wipcomputer/airplay-manual-vol/docs/design/01-front-view.png

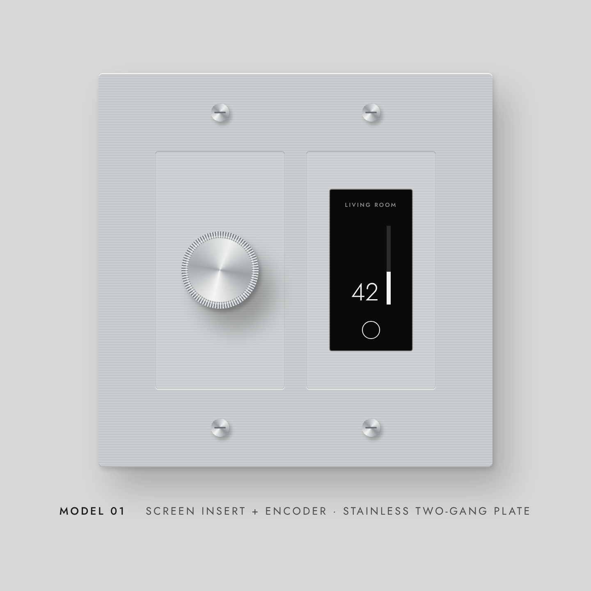
docs/design/01-front-view.png
