wipcomputer/airplay-manual-vol/docs/design/02-screen-states.png

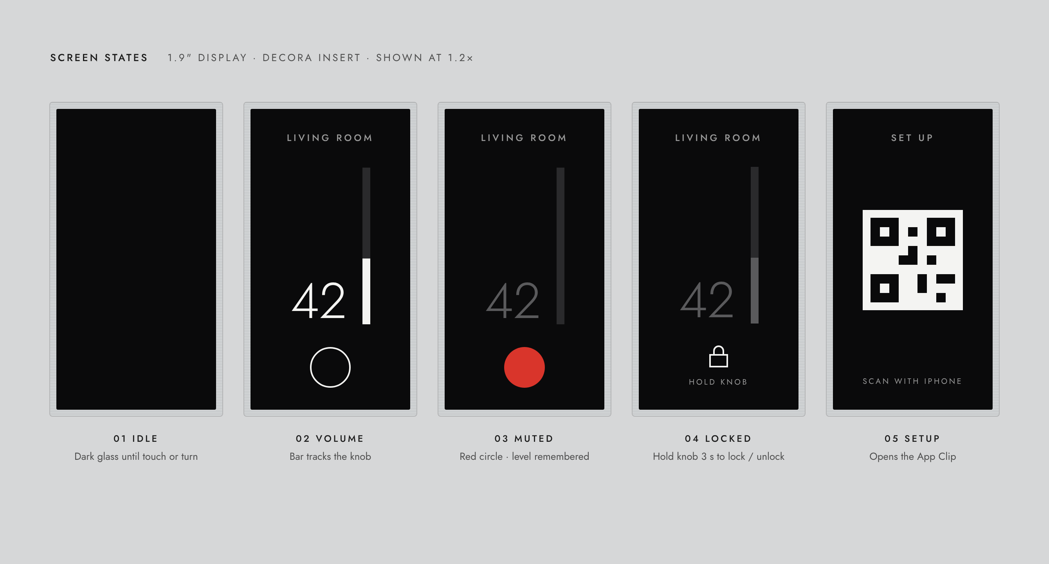
docs/design/02-screen-states.png
