wipcomputer/airplay-manual-vol/hardware/models/2k-knob2-bracket.stl

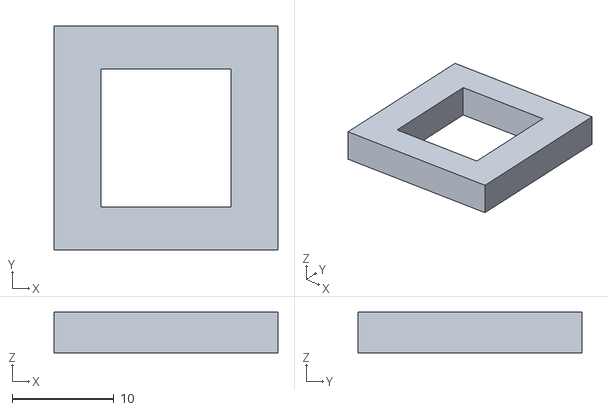
[picture p10: CAD file, 2026-10-14]
hardware/models/2k-knob2-bracket.stl
22.0 x 22.0 x 4.00
