wipcomputer/airplay-manual-vol/hardware/models/print/screen-acrylic.step

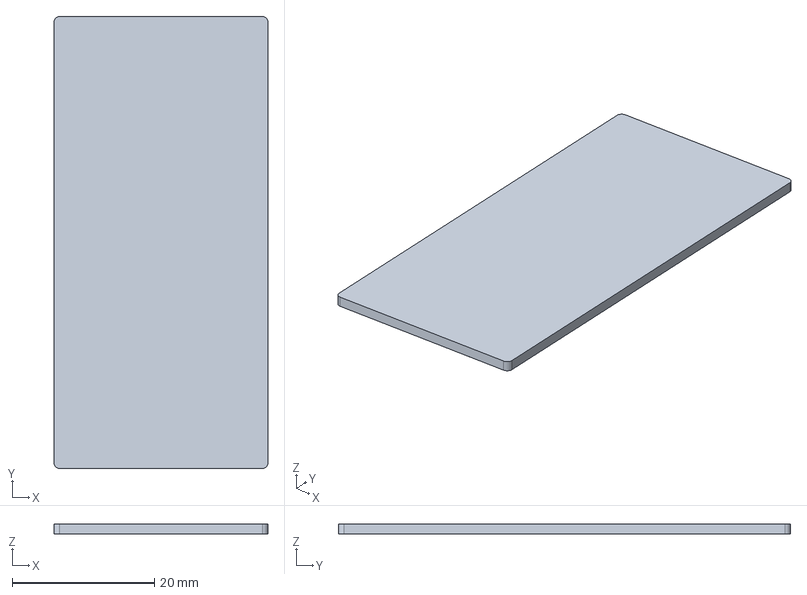
[picture p11: CAD file, 2026-10-14]
hardware/models/print/screen-acrylic.step
30.1 x 63.6 x 1.45 mm
