wipcomputer/airplay-manual-vol/hardware/models/3k-knob2-knob.stl

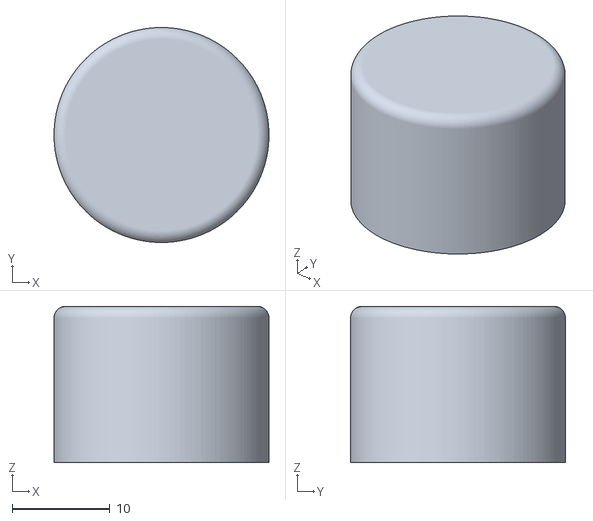
[picture p12: CAD file, 2026-10-14]
hardware/models/3k-knob2-knob.stl
22.0 x 22.0 x 16.0
