wipcomputer/airplay-manual-vol/hardware/models/print/knob-strap.step

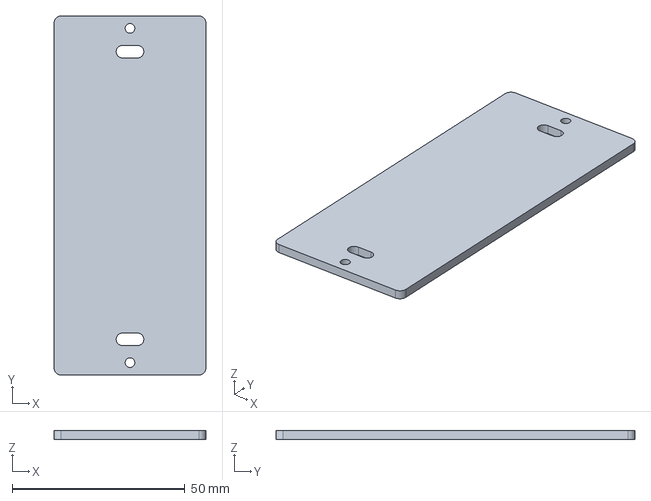
[picture p13: CAD file, 2026-10-14]
hardware/models/print/knob-strap.step
44.0 x 104.0 x 2.50 mm
