wipcomputer/airplay-manual-vol/hardware/models/1k-box.stl

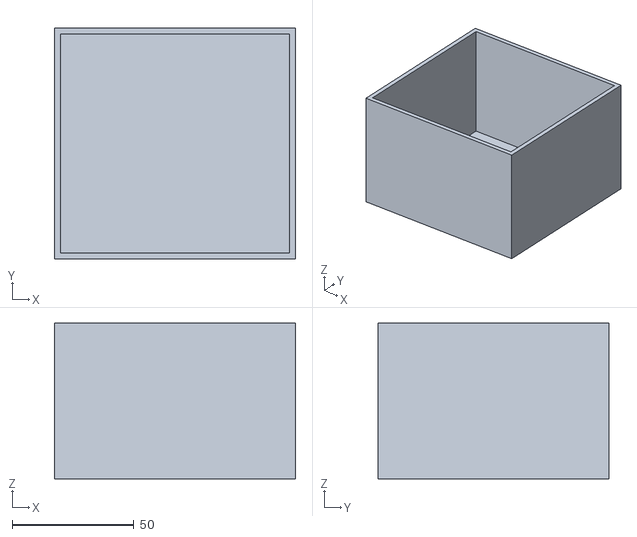
[picture p14: CAD file, 2026-10-14]
hardware/models/1k-box.stl
99.0 x 95.0 x 64.0
