wipcomputer/airplay-manual-vol/hardware/models/print/knob-face.step

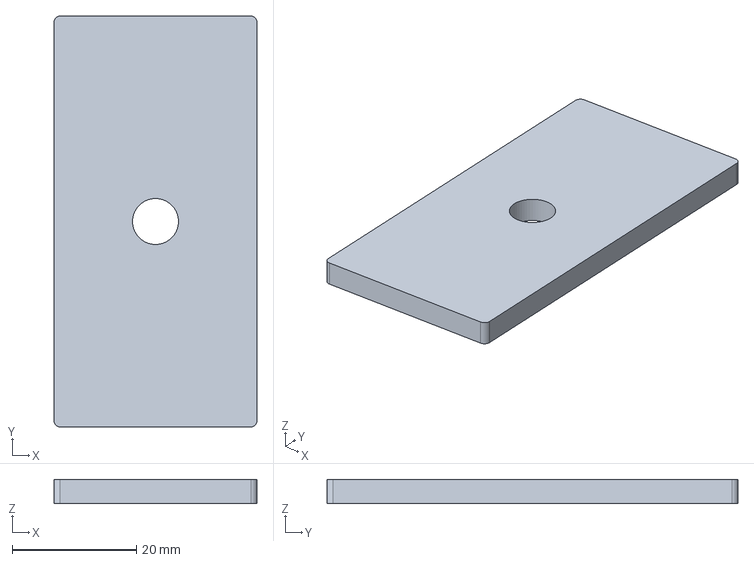
[picture p15: CAD file, 2026-10-14]
hardware/models/print/knob-face.step
32.7 x 66.2 x 3.90 mm
