wipcomputer/airplay-manual-vol/hardware/models/2k-box.stl

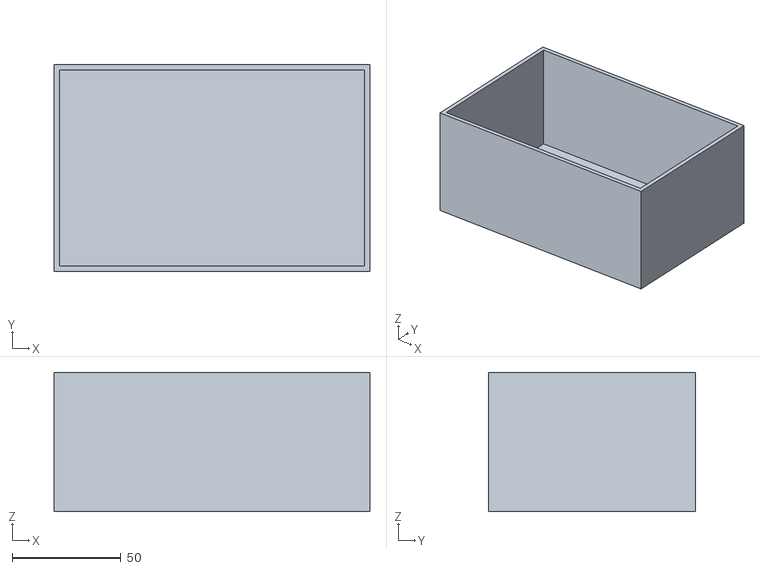
[picture p16: CAD file, 2026-10-14]
hardware/models/2k-box.stl
145.0 x 95.0 x 64.0
