wipcomputer/airplay-manual-vol/hardware/models/1k-knob1-encoder.stl

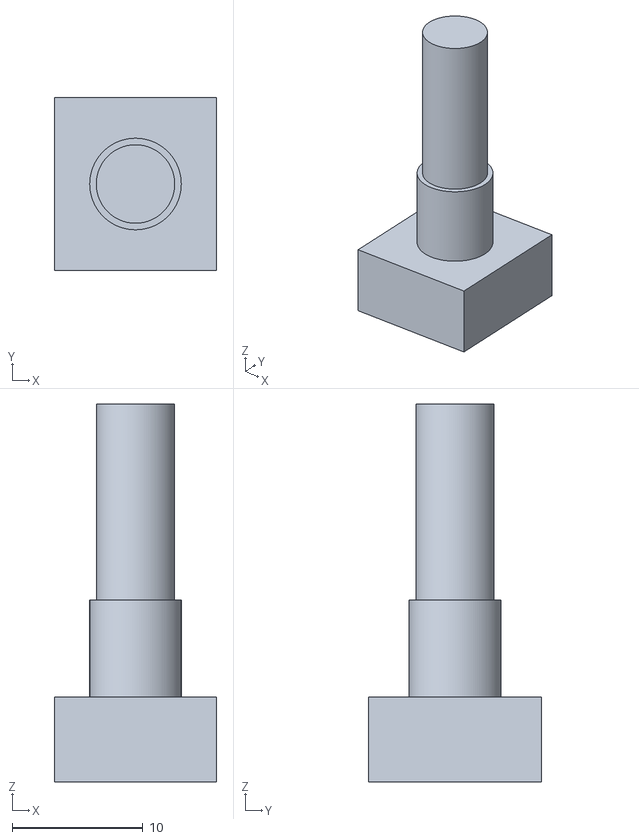
[picture p17: CAD file, 2026-10-14]
hardware/models/1k-knob1-encoder.stl
12.4 x 13.2 x 28.9
