wipcomputer/airplay-manual-vol/hardware/models/print/screen-face.step

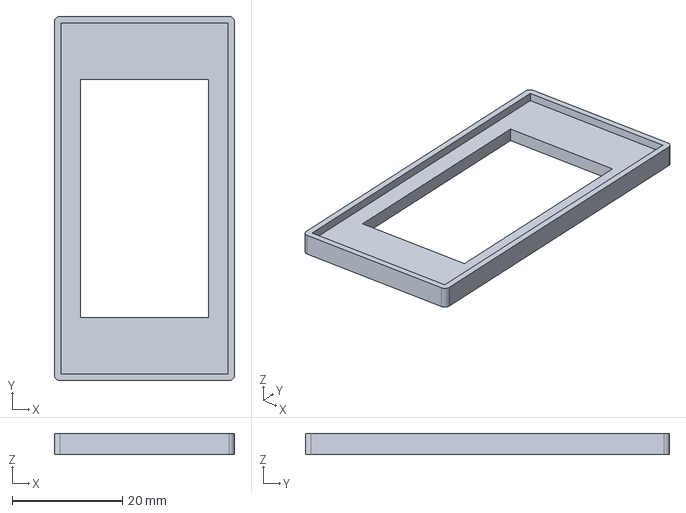
[picture p18: CAD file, 2026-10-14]
hardware/models/print/screen-face.step
32.7 x 66.2 x 3.90 mm
