wipcomputer/airplay-manual-vol/hardware/models/print/screen-housing.step

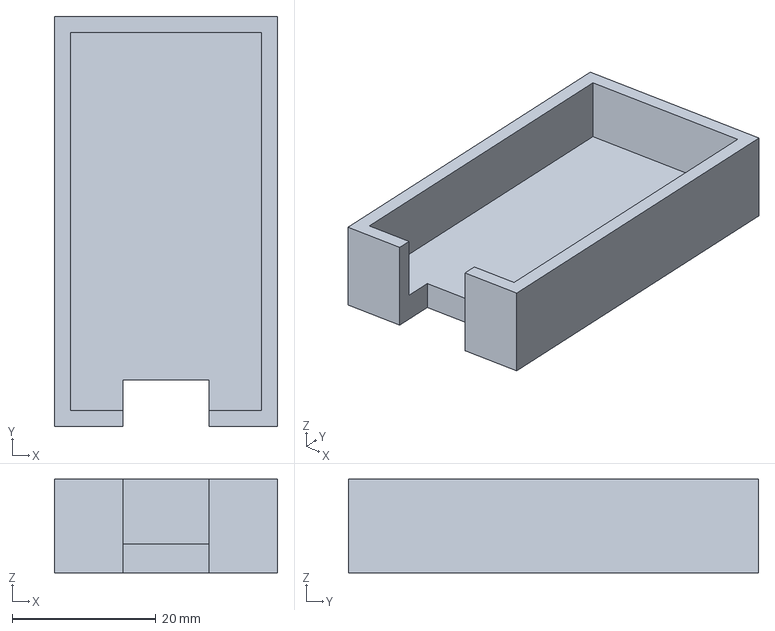
[picture p19: CAD file, 2026-10-14]
hardware/models/print/screen-housing.step
31.0 x 57.0 x 13.0 mm
