wipcomputer/airplay-manual-vol/hardware/models/2k-plate.stl

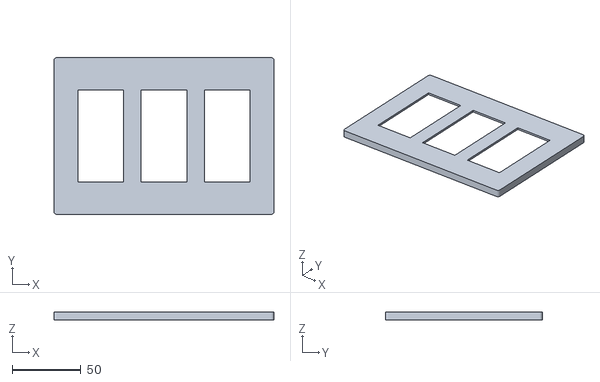
[picture p20: CAD file, 2026-10-14]
hardware/models/2k-plate.stl
160.3 x 114.3 x 6.00
