wipcomputer/airplay-manual-vol/hardware/models/3k-plate.stl

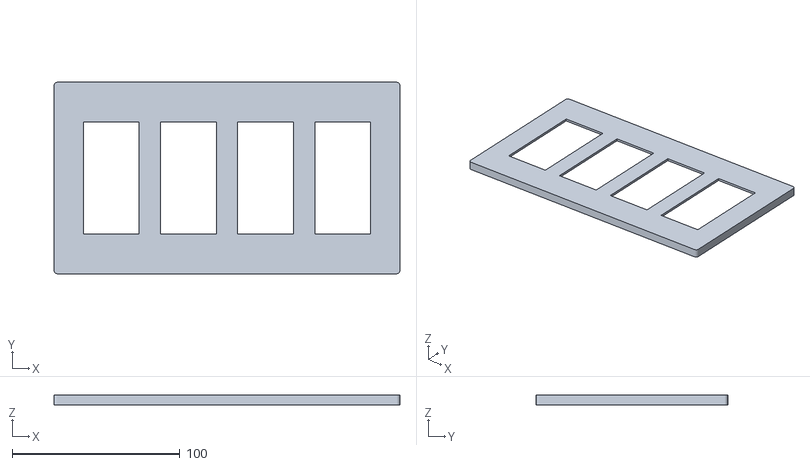
[picture p21: CAD file, 2026-10-14]
hardware/models/3k-plate.stl
206.4 x 114.3 x 6.00
