wipcomputer/airplay-manual-vol/hardware/models/2k-screen-board.stl

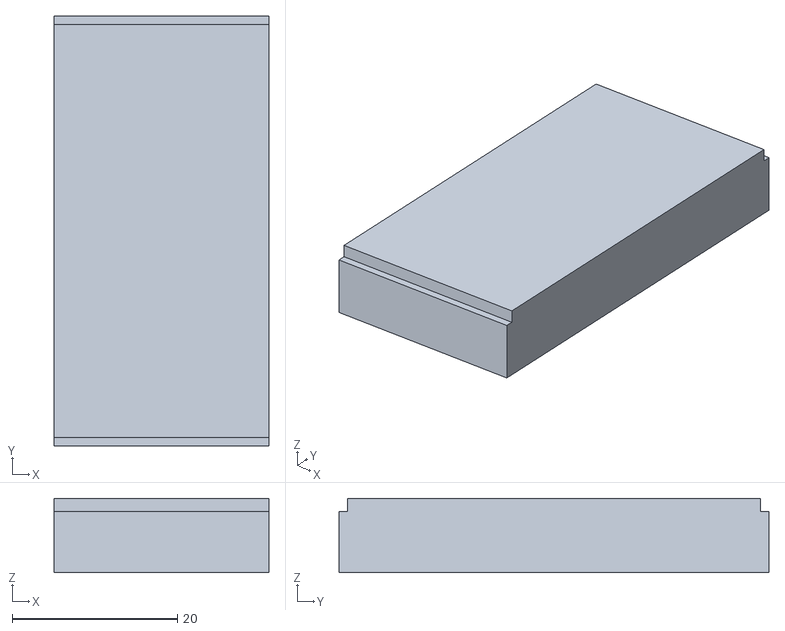
[picture p22: CAD file, 2026-10-14]
hardware/models/2k-screen-board.stl
26.0 x 52.0 x 9.00
