wipcomputer/airplay-manual-vol/hardware/models/3k-box.stl

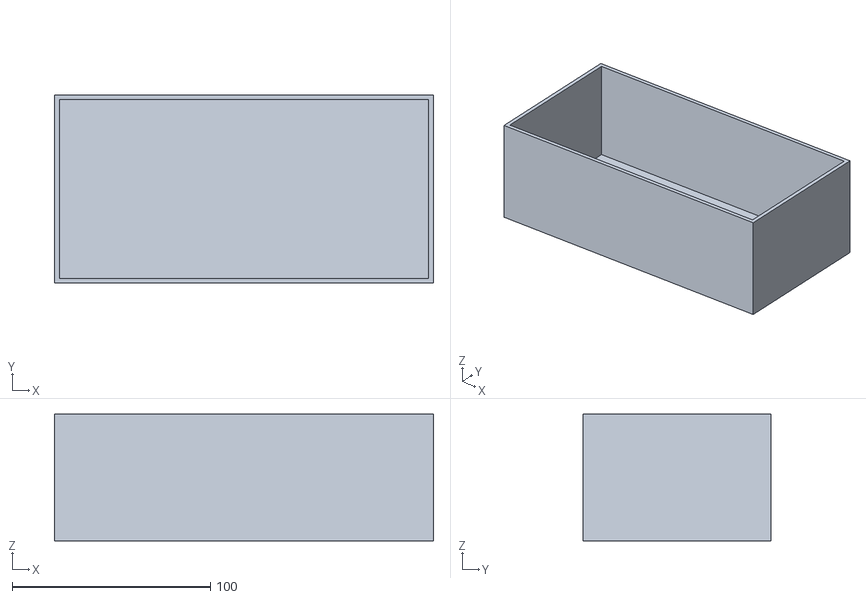
[picture p23: CAD file, 2026-10-14]
hardware/models/3k-box.stl
191.1 x 95.0 x 64.0
