wipcomputer/airplay-manual-vol/hardware/models/1k-plate.stl

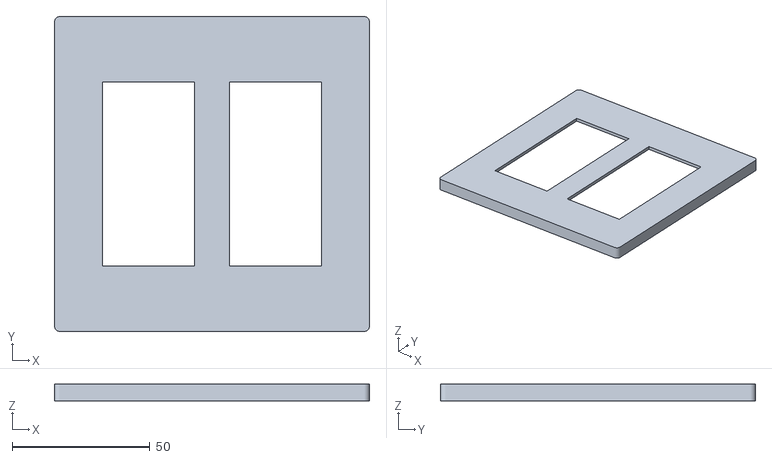
[picture p24: CAD file, 2026-10-14]
hardware/models/1k-plate.stl
114.3 x 114.3 x 6.00
