wipcomputer/airplay-manual-vol/(list of files, cad)

Other CAD files:
hardware/models/print/screen-strap.step
hardware/models/2k-screen-strap.stl
hardware/models/print/knob-bracket.step
hardware/models/1k-screen-face.stl
hardware/models/2k-knob1-face.stl
hardware/models/3k-knob3-face.stl
hardware/models/2k-knob2-knob.stl
hardware/models/3k-screen-strap.stl
hardware/models/2k-knob1-knob.stl
hardware/models/2k-knob1-strap.stl
hardware/models/2k-knob1-bracket.stl
hardware/models/2k-knob2-strap.stl
hardware/models/1k-knob1-strap.stl
hardware/models/3k-knob1-strap.stl
hardware/models/3k-screen-face.stl
hardware/models/3k-knob1-knob.stl
hardware/models/3k-knob2-face.stl
hardware/models/1k-screen-housing.stl
hardware/models/3k-screen-housing.stl
hardware/models/3k-knob1-bracket.stl
hardware/models/3k-knob3-strap.stl
hardware/models/2k-screen-acrylic.stl
hardware/models/1k-screen-acrylic.stl
hardware/models/2k-screen-housing.stl
hardware/models/1k-screen-strap.stl
hardware/models/1k-screen-board.stl
hardware/models/3k-knob3-encoder.stl
hardware/models/2k-screen-face.stl
hardware/models/2k-knob2-face.stl
hardware/models/3k-knob3-bracket.stl
hardware/models/2k-knob2-encoder.stl
hardware/models/3k-knob2-bracket.stl
hardware/models/1k-knob1-bracket.stl
hardware/models/3k-screen-board.stl
hardware/models/3k-knob2-strap.stl
hardware/models/2k-knob1-encoder.stl
hardware/models/3k-knob1-encoder.stl
hardware/models/3k-knob3-knob.stl
hardware/models/3k-knob1-face.stl
hardware/models/3k-screen-acrylic.stl
hardware/models/1k-knob1-face.stl
hardware/models/print/knob-bracket.stl
hardware/models/print/knob-face.stl
hardware/models/print/knob-strap.stl
hardware/models/print/screen-acrylic.dxf
hardware/models/print/screen-acrylic.stl
hardware/models/print/screen-face.stl
hardware/models/print/screen-housing.stl
hardware/models/print/screen-strap.stl
