wipcomputer/airplay-manual-vol/docs/design/Model-01-Mockups.pdf

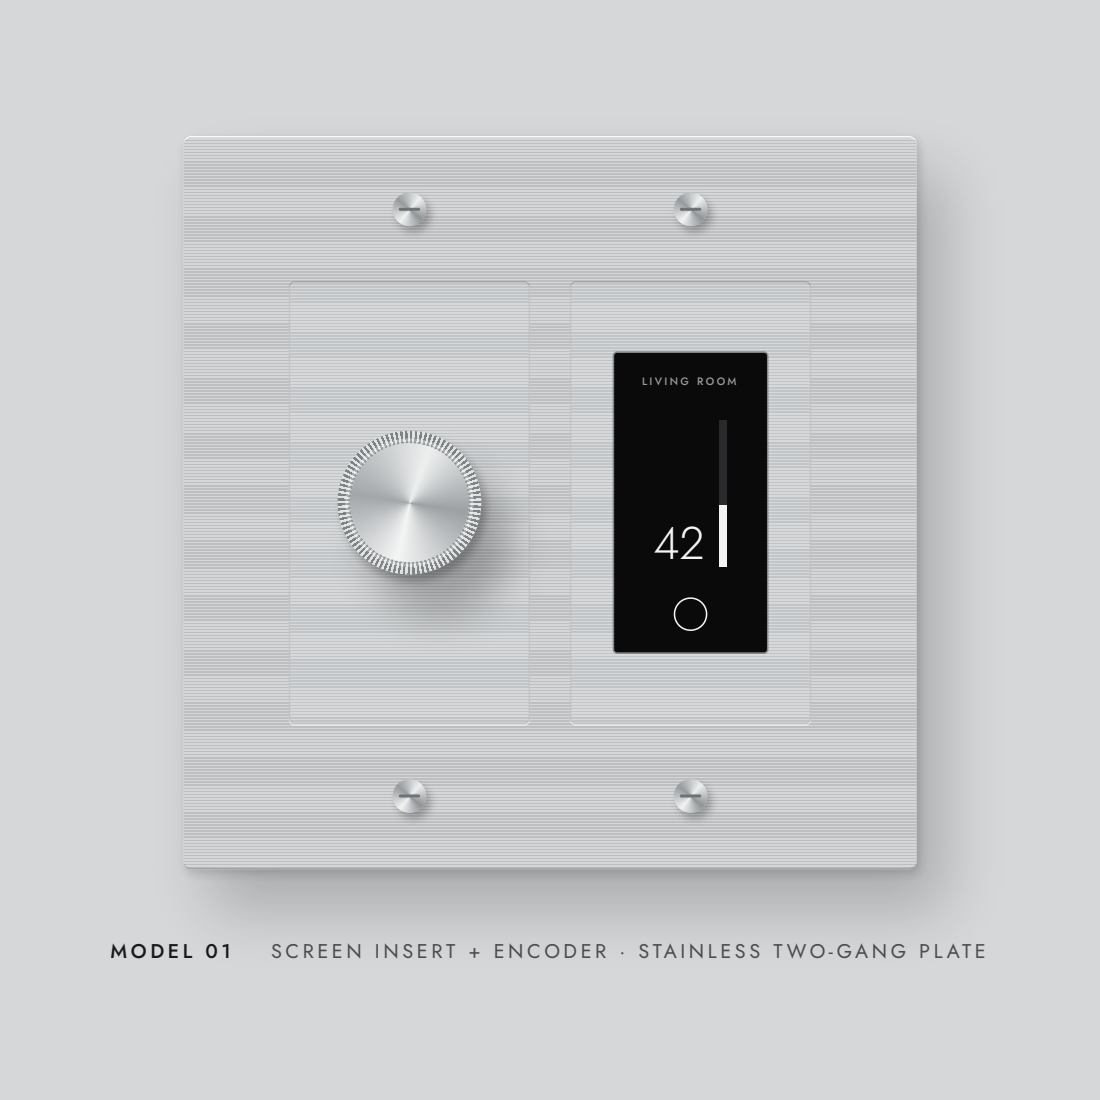
[picture p25: page 1]

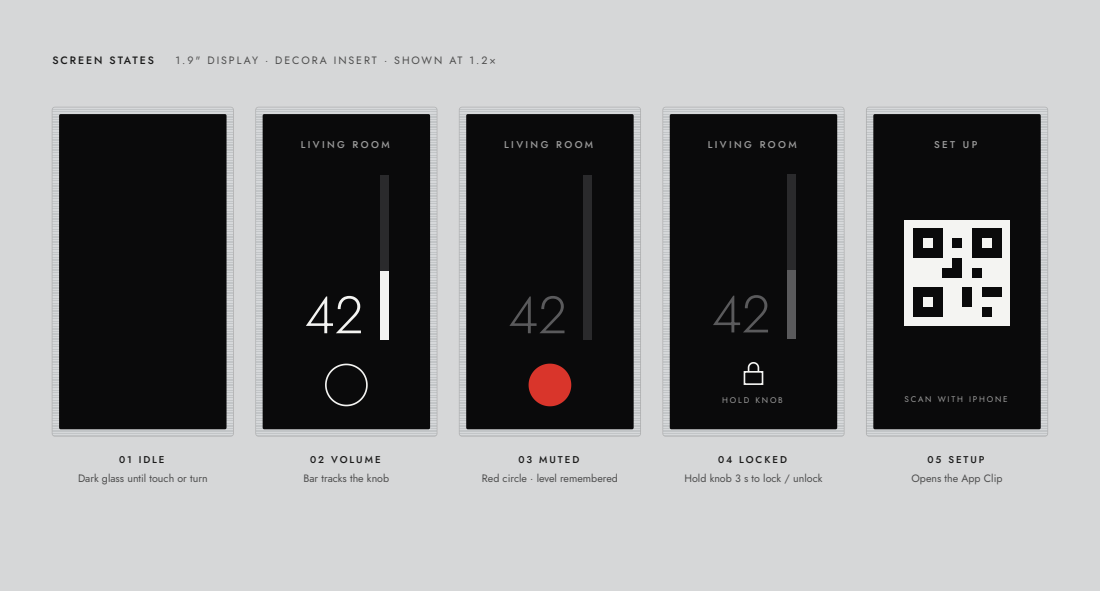
[picture p26: page 2]
S C R E E N S TAT E S

Dark glass until touch or turn

Bar tracks the knob

Red circle · level remembered

Hold knob 3 s to lock / unlock

Opens the App Clip

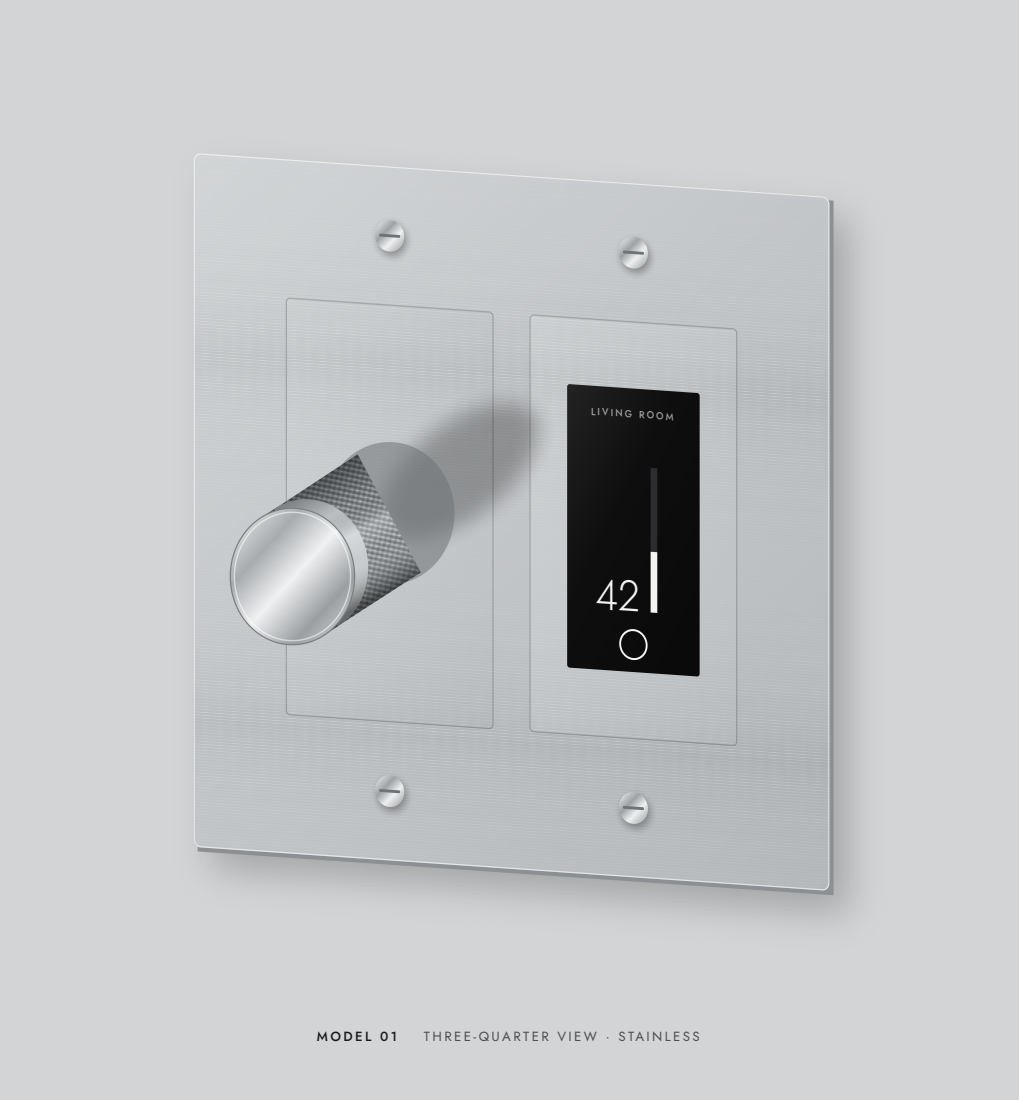
[picture p27: page 3]
