wipcomputer/airplay-manual-vol/firmware/main/board.c

#include "board.h"

#include "driver/gpio.h"
#include "driver/i2c_master.h"
#include "driver/ledc.h"
#include "driver/spi_master.h"
#include "esp_lcd_panel_io.h"
#include "esp_lcd_panel_ops.h"
#include "esp_lcd_panel_st7789.h"
#include "esp_lcd_touch_cst816s.h"
#include "esp_log.h"
#include "esp_lvgl_port.h"
#include "sdkconfig.h"

static const char *TAG = "board";

#define LCD_HOST SPI2_HOST
#define DRAW_LINES 40

void board_backlight(int percent)
{
    ledc_set_duty(LEDC_LOW_SPEED_MODE, LEDC_CHANNEL_0, (uint32_t)(percent * 8191 / 100));
    ledc_update_duty(LEDC_LOW_SPEED_MODE, LEDC_CHANNEL_0);
}

static void backlight_init(void)
{
    ledc_timer_config_t timer = {
        .speed_mode = LEDC_LOW_SPEED_MODE, .duty_resolution = LEDC_TIMER_13_BIT,
        .timer_num = LEDC_TIMER_0, .freq_hz = 5000, .clk_cfg = LEDC_AUTO_CLK,
    };
    ESP_ERROR_CHECK(ledc_timer_config(&timer));
    ledc_channel_config_t ch = {
        .gpio_num = CONFIG_WVP_LCD_BL, .speed_mode = LEDC_LOW_SPEED_MODE, .channel = LEDC_CHANNEL_0,
        .timer_sel = LEDC_TIMER_0, .duty = 0,
    };
    ESP_ERROR_CHECK(ledc_channel_config(&ch));
}

static esp_lcd_touch_handle_t touch_init(void)
{
    i2c_master_bus_config_t bus_cfg = {
        .i2c_port = I2C_NUM_0, .sda_io_num = CONFIG_WVP_TP_SDA, .scl_io_num = CONFIG_WVP_TP_SCL,
        .clk_source = I2C_CLK_SRC_DEFAULT, .glitch_ignore_cnt = 7, .flags.enable_internal_pullup = true,
    };
    i2c_master_bus_handle_t bus;
    ESP_ERROR_CHECK(i2c_new_master_bus(&bus_cfg, &bus));

    esp_lcd_panel_io_handle_t io;
    esp_lcd_panel_io_i2c_config_t io_cfg = ESP_LCD_TOUCH_IO_I2C_CST816S_CONFIG();
    io_cfg.scl_speed_hz = 400000;
    ESP_ERROR_CHECK(esp_lcd_new_panel_io_i2c(bus, &io_cfg, &io));

    esp_lcd_touch_config_t tp_cfg = {
        .x_max = LCD_H_RES, .y_max = LCD_V_RES,
        .rst_gpio_num = CONFIG_WVP_TP_RST, .int_gpio_num = CONFIG_WVP_TP_INT,
    };
    esp_lcd_touch_handle_t tp = NULL;
    if (esp_lcd_touch_new_i2c_cst816s(io, &tp_cfg, &tp) != ESP_OK) {
        ESP_LOGW(TAG, "touch controller not found; continuing without touch");
        return NULL;
    }
    return tp;
}

lv_display_t *board_init(void)
{
    backlight_init();

    spi_bus_config_t bus = {
        .sclk_io_num = CONFIG_WVP_LCD_SCLK, .mosi_io_num = CONFIG_WVP_LCD_MOSI,
        .miso_io_num = -1, .quadwp_io_num = -1, .quadhd_io_num = -1,
        .max_transfer_sz = LCD_H_RES * DRAW_LINES * sizeof(uint16_t),
    };
    ESP_ERROR_CHECK(spi_bus_initialize(LCD_HOST, &bus, SPI_DMA_CH_AUTO));

    esp_lcd_panel_io_handle_t io;
    esp_lcd_panel_io_spi_config_t io_cfg = {
        .dc_gpio_num = CONFIG_WVP_LCD_DC, .cs_gpio_num = CONFIG_WVP_LCD_CS,
        .pclk_hz = 40 * 1000 * 1000, .lcd_cmd_bits = 8, .lcd_param_bits = 8,
        .spi_mode = 0, .trans_queue_depth = 10,
    };
    ESP_ERROR_CHECK(esp_lcd_new_panel_io_spi((esp_lcd_spi_bus_handle_t)LCD_HOST, &io_cfg, &io));

    esp_lcd_panel_handle_t panel;
    esp_lcd_panel_dev_config_t panel_cfg = {
        .reset_gpio_num = CONFIG_WVP_LCD_RST, .rgb_ele_order = LCD_RGB_ELEMENT_ORDER_RGB, .bits_per_pixel = 16,
    };
    ESP_ERROR_CHECK(esp_lcd_new_panel_st7789(io, &panel_cfg, &panel));
    ESP_ERROR_CHECK(esp_lcd_panel_reset(panel));
    ESP_ERROR_CHECK(esp_lcd_panel_init(panel));
    ESP_ERROR_CHECK(esp_lcd_panel_invert_color(panel, true));   // IPS ST7789 panels are inverted
    ESP_ERROR_CHECK(esp_lcd_panel_set_gap(panel, CONFIG_WVP_LCD_X_GAP, CONFIG_WVP_LCD_Y_GAP));
    ESP_ERROR_CHECK(esp_lcd_panel_disp_on_off(panel, true));

    const lvgl_port_cfg_t lvgl_cfg = ESP_LVGL_PORT_INIT_CONFIG();
    ESP_ERROR_CHECK(lvgl_port_init(&lvgl_cfg));
    const lvgl_port_display_cfg_t disp_cfg = {
        .io_handle = io, .panel_handle = panel,
        .buffer_size = LCD_H_RES * DRAW_LINES, .double_buffer = true,
        .hres = LCD_H_RES, .vres = LCD_V_RES, .monochrome = false,
        .color_format = LV_COLOR_FORMAT_RGB565,
        .flags = { .buff_dma = true, .swap_bytes = true },
    };
    lv_display_t *disp = lvgl_port_add_disp(&disp_cfg);

    esp_lcd_touch_handle_t tp = touch_init();
    if (tp) {
        const lvgl_port_touch_cfg_t touch_cfg = { .disp = disp, .handle = tp };
        lvgl_port_add_touch(&touch_cfg);
    }

    board_backlight(100);
    ESP_LOGI(TAG, "display %dx%d ready%s", LCD_H_RES, LCD_V_RES, tp ? ", touch ready" : "");
    return disp;
}
