wipcomputer/airplay-manual-vol/firmware/main/wifi.c

#include "wifi.h"

#include <string.h>
#include "esp_event.h"
#include "esp_log.h"
#include "esp_netif.h"
#include "esp_wifi.h"
#include "freertos/FreeRTOS.h"
#include "freertos/event_groups.h"
#include "sdkconfig.h"

static const char *TAG = "wifi";
static EventGroupHandle_t events;
#define CONNECTED_BIT BIT0

static void on_event(void *arg, esp_event_base_t base, int32_t id, void *data)
{
    if (base == WIFI_EVENT && id == WIFI_EVENT_STA_START) {
        esp_wifi_connect();
    } else if (base == WIFI_EVENT && id == WIFI_EVENT_STA_DISCONNECTED) {
        xEventGroupClearBits(events, CONNECTED_BIT);
        ESP_LOGW(TAG, "disconnected; reconnecting");
        esp_wifi_connect();
    } else if (base == IP_EVENT && id == IP_EVENT_STA_GOT_IP) {
        ip_event_got_ip_t *ev = data;
        ESP_LOGI(TAG, "connected, IP " IPSTR, IP2STR(&ev->ip_info.ip));
        xEventGroupSetBits(events, CONNECTED_BIT);
    }
}

bool wifi_connect(int timeout_ms)
{
    events = xEventGroupCreate();
    ESP_ERROR_CHECK(esp_netif_init());
    ESP_ERROR_CHECK(esp_event_loop_create_default());
    esp_netif_create_default_wifi_sta();
    wifi_init_config_t init = WIFI_INIT_CONFIG_DEFAULT();
    ESP_ERROR_CHECK(esp_wifi_init(&init));
    ESP_ERROR_CHECK(esp_event_handler_register(WIFI_EVENT, ESP_EVENT_ANY_ID, on_event, NULL));
    ESP_ERROR_CHECK(esp_event_handler_register(IP_EVENT, IP_EVENT_STA_GOT_IP, on_event, NULL));

    wifi_config_t cfg = { 0 };
    strlcpy((char *)cfg.sta.ssid, CONFIG_WVP_WIFI_SSID, sizeof cfg.sta.ssid);
    strlcpy((char *)cfg.sta.password, CONFIG_WVP_WIFI_PASSWORD, sizeof cfg.sta.password);
    ESP_ERROR_CHECK(esp_wifi_set_mode(WIFI_MODE_STA));
    ESP_ERROR_CHECK(esp_wifi_set_config(WIFI_IF_STA, &cfg));
    ESP_ERROR_CHECK(esp_wifi_set_ps(WIFI_PS_NONE));   // lowest latency for knob turns
    ESP_ERROR_CHECK(esp_wifi_start());

    EventBits_t bits = xEventGroupWaitBits(events, CONNECTED_BIT, pdFALSE, pdTRUE, pdMS_TO_TICKS(timeout_ms));
    return bits & CONNECTED_BIT;
}

bool wifi_is_connected(void)
{
    return events && (xEventGroupGetBits(events) & CONNECTED_BIT);
}
